bitcraze/crazyflie-electronics/README.md

# Crazyflie Electronics
Datasheets and KiCad project files for the Crazyflie 1.0 electronics design.

For more information see the [wiki](https://wiki.bitcraze.io/projects:crazyflie:index)
