bitcraze/crazyflie-electronics/(threads)

Thread 1 (2017-06-14):

Where are the electronics for Crazyflie 2?

whmountains, 2017-06-14:
The website says all the hardware and software is open-source on GitHub, but I can't find the board files for the Crazyflie 2.0 anywhere.

Is that something you've chosen not to release, or am I just not looking hard enough?  Thanks a lot!

tobbeanton, 2017-06-15:
Sorry, the KiCad files for Crazyflie 2.0 are not published publicly.

tinkertux, 2018-02-27:
Where we can get the Kicad files for Crazyflie 2.0?
We can only get the PDF files for Crazyflie 2.0?

ataffanel, 2018-02-28:
The Kicad files is something we have not published yet. So yes you can only get the PDFs schematic and  component placement of Crazyflie 2.0.

tinkertux, 2018-03-01:
OK！Thank you！

Closed 2018-02-28.
