bitcraze/crazyflie-electronics/(commit log)

2013-07-29 Initial commit of Crazyflie electronics and datasheets.
    [Crazyflie contol board.brd, Crazyflie contol board.sch, IMU.sch, Power.sch, Wireless.sch]
2013-10-03 Updated board to new pcb layout format. Increased PCB arm curve thickness a tiny bit.
    [Crazyflie contol board.brd, Crazyflie contol board.kicad_pcb]
