bitcraze/crazyflie-electronics/(notices)

Notices in the files:
ecad/IMU.sch:
Bitcraze AB (CC BY-NC-SA)
